pgu1458/Smart-Factory-Conveyor-AGV-Firmware/최종 하드웨어 회로도 2.ps.png

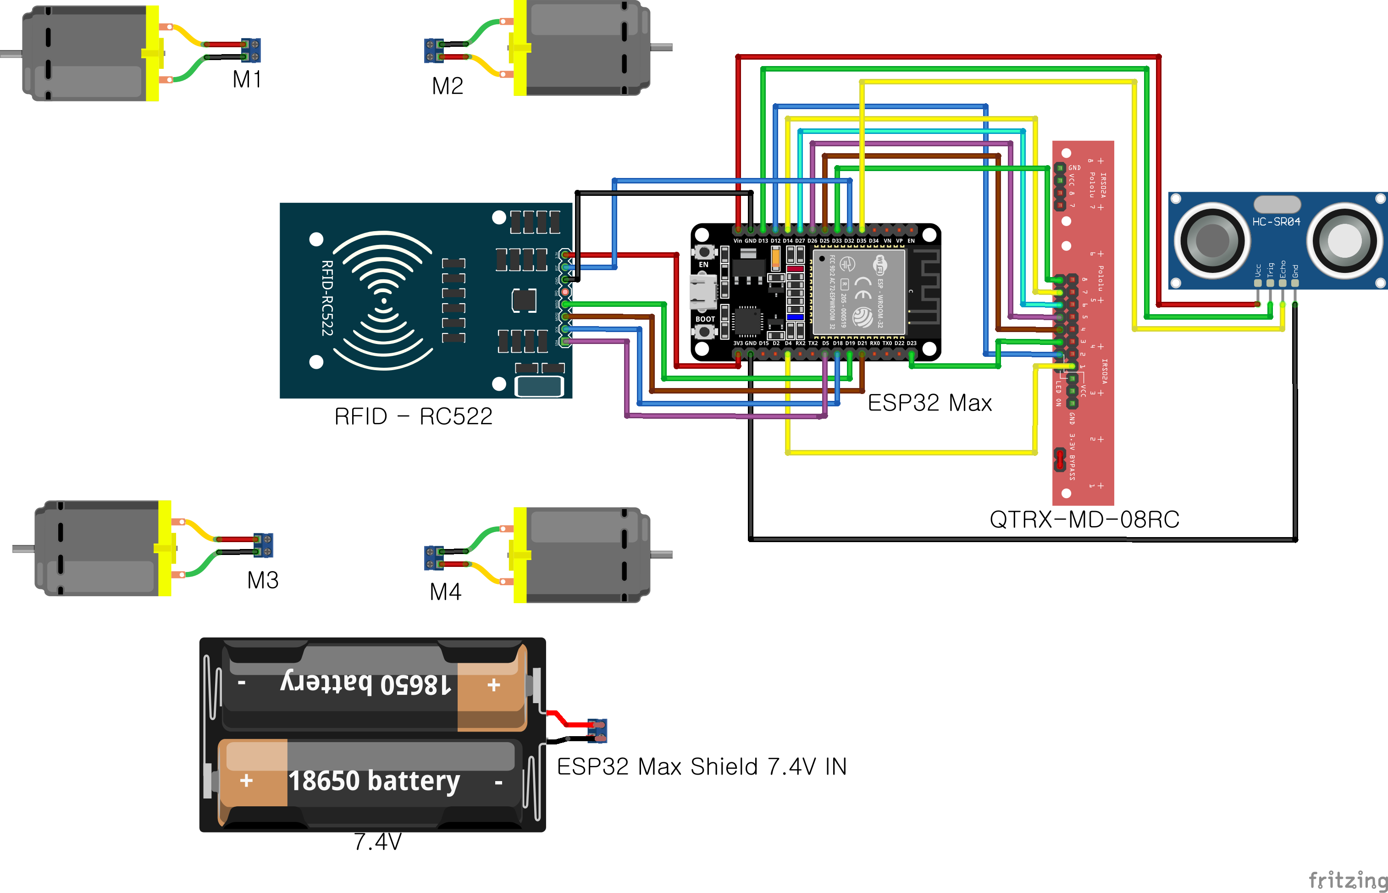
최종 하드웨어 회로도 2.ps.png
